BGCX262/zyrandol2-svn-to-git/trunk/doc/main.odt

Przełącznik do żyrandola 2

Do czego to służy?

Jest to urządzenie, które może się przydać każdemu kto chce obsługiwać żyrandol dwusekcyjny za pomocą przełącznika jednoobwodowego. Przykładem zastosowania może być sytuacja z życia wzięta kiedy kupujemy nowy żyrandol z dwiema sekcjami, lecz instalacja elektryczna pozwala obsłużyć tylko jedną sekcję (pod tynkiem znajduje się przewód dwużyłowy). Normalnie wymagałoby to wymiany przewodu na przynajmniej trójżyłowy, natomiast można tego uniknąć stosując opisany układ. Umożliwia on sterowanie żyrandolem poprzez jeden klawisz włącznika oświetlenia. Każde jego krótkie wyłączenie i włączenie zmienia stan sekcji żyrandola na kolejny. Stany te można opisać: świeci sekcja L1, świeci sekcja L2 i świecą obie sekcje.

W numerze EdW 08/2010 opisałem pierwszą wersję urządzenia, natomiast to jest kolejną, dostosowaną do teraźniejszych warunków przepisowo-prawnych odsłoną tego samego pomysłu. Przypomnę, że poprzednia wersja umożliwiała pracę tylko z żarówkami, natomiast wersja opisywana teraz umożliwia pracę z klasycznymi żarówkami, świetlówkami energoszczędnymi oraz „żarówkami” LED w roli źródeł światła w żyrandolu. A ponieważ żarówki na mocy dyrektyw UE stopniowo zostały wycofane koniecznością okazało się opracowanie nowej wersji urządzenia umożliwiającej pracę z nowoczesnymi źródłami światła takimi jak wspomniane świetlówki energoszczędne i lampy LED. Zasadnicza różnica pomiędzy tą a poprzednią wersją urządzenia polega na zmianie sposobu zasilania. W poprzedniej wersji układ „podkradał” energię przeznaczoną dla żarówki, zmieniając w nieznaczny sposób kształt przebiegu napięcia zasilającego dlań przeznaczonego. Świetlówki energoszczędne posiadające w swoim wnętrzu wbudowane układy elektroniczne są bardzo czułe na zmiany kształtu napięcia zasilania przez co ich prawidłowe funkcjonowanie było niemożliwe. W obecnej postaci do odbiornika stanowiącego źródło światła doprowadzane jest napięcie zasilające bez żadnych „ubytków”, przez co możliwa jest praca ze znaczną większością dostępnych na rynku źródeł światła.

Najważniejsze cechy urządzenia:

- możliwość sterowania dwiema sekcjami oświetlenia jednym klawiszem wyłącznika;
- praca ze świetlówkami energoszczędnymi i żarówkami LED;
- pamięć ostatniego stanu oświetlenia;
- płytka przeznaczona do zamontowania w podsufitce żyrandola.

Jak to działa?

Schemat elektryczny przedstawiony jest na rys.1. Dwa triaki T1 i T2 załączają odpowiednio sekcje L1 i L2, składające się z pewnej grupy źródeł światła. Triaki dostarczają energię do odbiorników w całym okresie przebiegu, poczynając od przejścia przebiegu napięcia sieci przez zero. Triaki są sterowane z wyjść mikrokontrolera U1 poprzez rezystory ograniczające prąd R2, R3.

Układ jest zasilany z zasilacza beztransformatorowego, który zbudowany jest z elementów C1, R6, D1, DZ1, C2. Jest to zasilacz jednopołówkowy, ograniczający prąd płynący od ujemnej szyny zasilania układu. Umieszczenie zasilacza po tej stronie było podyktowane chęcią uzyskania jednakowego potencjału na elektrodach T1 triaków i na dodatniej szynie zasilania. Pomaga to optymalnie wykorzystać charakterystykę sterowania triaka BT136, czyli używanie mniejszych wymaganych prądów bramki: dla T2+G- 8mA i T2-G- 11mA (po szczegóły odsyłam do dokumentacji triaka BT136).

Praca mikrokontrolera jest zsynchronizowana z przebiegiem napięcia sieci dzięki obecności rezystorów ograniczających prąd R7 i R8, połaczonych szeregowo w celu zwiększenia napięcia pracy. Synchronizacja umożliwia wysterowanie triaka krótkimi impulsami podawanymi na bramkę; mikrokontroler jest w stanie stwierdzić, w którym momencie i na jak długo wysterować bramkę, wystarczająco aby przez cały okres trwania połówki napięcia zasilającego triak był w stanie przewodzenia. Synchronizacja z siecią dostarcza również informacji o stanie wyłącznika, co z kolei wpływa na stan sekcji świecących L1 i L2.

Z głównego założenia projektu wynika, że układ pracuje w pewnym momencie w odcięciu od napięcia sieci. Podczas przełączania między stanami żyrandola na chwilę napięcie jest odcinane. Zasilanie do mikrokontrolera jest wtedy dostarczane z kondensatora C2 o wystarczająco dużej pojemności 1000uF.

Mikrokontroler U1 ATTINY13A pracuje w konfiguracji z wewnętrznym źródłem sygnału zegarowego o częstotliwości 4,8MHz, co przy zasilaniu 5V daje prąd zasilania około 3mA. Program mikrokontrolera wykorzystuje dwa źródła przerwań: przerwanie od przepełnienia T0 oraz przerwanie zewnętrzne INT0 reagujące na zbocze rosnące, generujące zdarzenia dla synchronizacji z siecią.

Ośmiobitowy timer T0 jest taktowany niepodzielonym sygnałem zegarowym, czyli przerwanie od przepełnienia występuje co około 53.3us. Daje to 375 przerwań na jeden okres sieci i 18750 przerwań na sekundę. Przerwanie zewnętrzne INT0 jest skonfigurowane na występowanie podczas zbocza rosnącego. Przerwanie od przepełnienia T0 inkrementuje licznik globalny T, natomiast wystąpienie INT0 go zeruje.

Sterowanie triakami odbywa się w cyklach odpowiadających okresom sieci zasilającej. Przerwanie INT0 występuje tuż przed wystąpieniem przejścia napięcia sieci przez zero. Dokładniej mówiąc występuje ono w okolicy „zera”, gdy na dodatniej szynie zasilania panuje jeszcze napięcie większe niż na „gorącej” końcówce C1; czyli wtedy, gdy różnica między „gorącą” końcówką C1 a ujemną szyną zasilania jest równa napięciu progowemu do przejścia z poziomu L do H pinu U1.

W chwili wystąpienia przerwania INT0 odpalane są triaki, w zależności od stanu jeden z nich albo obydwa. Impuls na bramkę podawany jest przez 3ms. Po 10ms od wystąpienia przerwania na triaki podawany jest kolejny impuls, również na czas 3ms. Przy kolejnym przejściu przez zero cykl się powtarza.

Jeżeli napięcie zasilania zostało odłączone (wyłączenie wyłącznika) cykl się zostaje przerwany, ale licznik globalny T jest inkrementowany dalej. Po 200ms od zaniku napięcia zasilania w RAM zapisywana jest informacja o konieczności zmiany stanu przy powrocie napięcia sieci. Jeżeli przez parę sekund napięcie nie powróci mikrokontroler zrestartuje się, ponieważ napięcie na C2 spadnie poniżej BODLEVEL ustawionego na 2.7V. Jeśli jednak napięcie szybko powróci wówczas mikrokontroler wraz z wystąpieniem pierwszego przerwania INT0 sprawdzi flagę zmiany stanu i, jeśli czas był dłuższy niż 200ms zmieni stan oświetlenia na następny, i zapisze go do EEPROM.

Stan oświetlenia jest ładowany przy każdym włączeniu z pamięci EEPROM.

Program został napisany w języku C z wykorzystaniem środowiska AVR Studio. Zainteresowani mogą znaleźć szczegóły implementacji w udostępnionych plikach z kodem źródłowym, dostępnych na stronie Elportalu.

Montaż I uruchomienie

Układ można zmontować na płytce pokazanej na rysunku rys. 2. Sposób montażu ostatecznie różni się od montażu wersji prototypowej widocznej na zdjęciu tytułowym. Między innymi zostały zmienione miejscami zaciski CON1 i CON2, ułożenie triaków oraz zastosowany został układ U1 w obudowie SOIC zamiast PDIP (montaż „na plecach”).

Zmontowanie płytki może przebiegać w standardowy sposób, czyli poczynając od elementów od najmniejszych gabarytów. Jeżeli ktoś nie przewiduje programowania mikrokontrolera może nie montować złącza ISP CON4. Po zmontowaniu układu należy sprawdzić jakość połączeń, czyli brak zimnych lutów oraz zwarć między ścieżkami, posługując się przy tym multimetrem. Poprawnie zmontowany układ nie wymaga specjalnego uruchamiania.

Jednak przed przystąpieniem do uruchamiania należy mieć na uwadze, że urządzenie w trakcie pracy cały czas znajduje się pod napięciem sieci. Z tego powodu należy zachować szczególną ostrożność, a osoby niewykwalifikowane w pracy pod napięciem sieci 230VAC powinny poprosić o pomoc w uruchomieniu osobę, która takie kwalifikacje posiada.

Docelowo urządzenie ma być montowane w podsufitce żyrandola, jednak przed montażem dobrze jest przetestować jego działanie na stole. W tym celu należy przygotować przewód sieciowy z wyłącznikiem oraz dwa źródła światła (żarówki, świetlówki energooszczędne albo żarówki LED). Przewód sieciowy należy podłączyć do zacisku CON1, źródła światła do CON2 i CON3.

Po włączeniu zasilania za pomocą włącznika powinna się zaświecić żarówka podłączona do CON2. Następnie na około pół sekundy należy za pomocą wyłącznika odciąć na około sekundę zasilanie sieciowe, po czym powinna nastąpić zmiana stanu oświetlenia (zaświeci się źródło światła podłączone do CON1), po następnej krótkiej przerwie powinny zaświecić się oba źródła, itd.

Jeśli układ przeszedł test pozytywnie można montować go w podsufitce. Duży otwór na środku płytki pozwala na umieszczenie układu na rurce która doprowadzone są przewody do żyrandola od strony instalacji.

Podłączenie układu przebiega analogicznie jak podczas uruchomienia testowego – do zacisku CON1 podłączamy przewody z instalacji, natomiast przewody od sekcji żyrandola do CON2 i CON3.

Piotr Wójtowicz

pw@elportal.pl
