BGCX262/zyrandol2-svn-to-git/(list of files, drawings)

Other design files:
trunk/avt/delivery/pcb/zyrandol2.dsn
trunk/avt/wojtowicz.zyrandol.pcb/zyrandol2.dsn
trunk/pcb/zyrandol2.dsn
