BGCX262/zyrandol2-svn-to-git/trunk/pcb/zyrandol2.sch

## KiCad design trunk/pcb/zyrandol2.sch (2015-08-23)

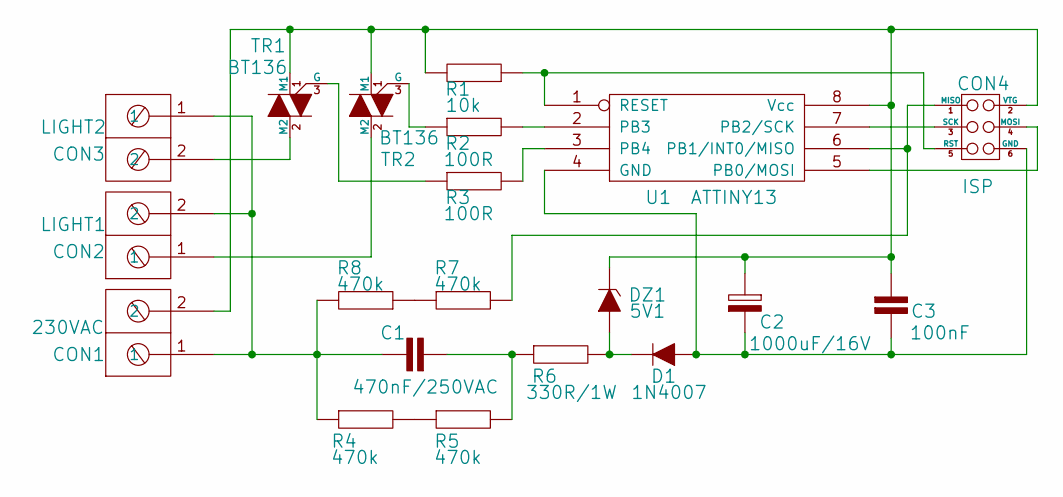
[picture p1: schematic zyrandol2.sch]

Parts:
C1: 470nF/250VAC
C2: 1000uF/16V
C3: 100nF
CON1: 230VAC
CON2: LIGHT1
CON3: LIGHT2
CON4: ISP
D1: 1N4007
DZ1: 5V1
R1: 10k
R2, R3: 100R
R4, R5, R7, R8: 470k
R6: 330R/1W
TR1, TR2: BT136
U1: ATTINY13

Connections:
unnamed: C1.1, R5.2, R6.1
unnamed: C1.2, CON1.1, CON2.2, CON3.1, R4.1, R8.2
unnamed: C2.1, C3.1, CON1.2, CON4.2 (VTG), DZ1.2, R1.2, TR1.1 (M1), TR2.1 (M1), U1.8 (Vcc)
unnamed: C2.2, C3.2, CON4.6 (GND), D1.1, U1.4 (GND)
unnamed: CON2.1, TR2.2 (M2)
unnamed: CON3.2, TR1.2 (M2)
unnamed: CON4.1 (MISO), R7.2, U1.6 (PB1/INT0/MISO)
unnamed: CON4.3 (SCK), U1.7 (PB2/SCK)
unnamed: CON4.4 (MOSI), U1.5 (PB0/MOSI)
unnamed: CON4.5 (RST), R1.1, U1.1 (RESET)
unnamed: D1.2, DZ1.1, R6.2
unnamed: R2.1, TR2.3 (G)
unnamed: R2.2, U1.2 (PB3)
unnamed: R3.1, TR1.3 (G)
unnamed: R3.2, U1.3 (PB4)
unnamed: R4.2, R5.1
unnamed: R7.1, R8.1
